ansvonwa/frisbee/Arduino/frisbee/CaptivePortal.ino

/*
   Captive Portal by: M. Ray Burnette 20150831
   See Notes tab for original code references and compile requirements
   Sketch uses 300,640 bytes (69%) of program storage space. Maximum is 434,160 bytes.
   Global variables use 50,732 bytes (61%) of dynamic memory, leaving 31,336 bytes for local variables. Maximum is 81,920 bytes.
*/

#include <ESP8266WiFi.h>
#include "./DNSServer.h"                  // Patched lib

const byte        DNS_PORT = 53;          // Capture DNS requests on port 53
IPAddress         apIP(10, 10, 10, 1);    // Private network for server
DNSServer         dnsServer;              // Create the DNS object


bool _CP_running = false;

void CP_setup() {
  WiFi.mode(WIFI_AP_STA);
  WiFi.softAPConfig(apIP, apIP, IPAddress(255, 255, 255, 0));
  WiFi.softAP("Frisbee Settings");
  WiFi.hostname("Frisbee");

  // if DNSServer is started with "*" for domain name, it will reply with
  // provided IP to all DNS request
  dnsServer.start(DNS_PORT, "*", apIP);

  _CP_running = true;
}

inline bool CP_running() {
  return _CP_running;
}

inline void CP_loop() {
  if (_CP_running) {
    dnsServer.processNextRequest();
  }
}
