ansvonwa/frisbee/(commit log)

2019-08-23 replace pos1000 by mLEDshift
    [frisbee.ino]
2019-11-24 make ReversedDots colorful; uncomment ColorByDirection
    [frisbee.ino]
2019-11-24 add switch of animation on collision
    [frisbee.ino]
2020-01-09 switchOnCollision = true
2020-06-20 add captive portal with animation selection (still buggy, wifi disappears sometimes)
    [CaptivePortal.ino, DNSServer.cpp, Notes.h, frisbee.ino]
2020-06-25 increase reversed rotation speed on ReversedDots
    [frisbee.ino]
2020-06-25 fix bug in ColorByDirection causing green to be to dark
    [frisbee.ino]
2020-10-01 prefer switch on collosion
